iblue/mhi-xy-bus/(threads)

Thread 1 (2025-06-16):

Missing annexes in document - schematic + reference implementation

roelbouw, 2025-06-16:
Great work on the protocol analysis.

The "Project scope" section of your document lists a description/schematic of the circuitry used in appendix A, and an Arduino example implemenation in Annex B.

However, the document in this git does not include either Annex. Would you mind also publishing those?
