iblue/mhi-xy-bus/aircohack/Disconnector.asc

M1: nmos; BSP89
Q1: npn; BC547C
R1: res; 100k
R2: res; 10k
R3: res; 100k
V1: voltage; 17V
Named nets: 0
.tran 100m
