iblue/mhi-xy-bus/aircohack/Drive2r.asc

100k: res; 47k
C1: cap; 100µ
C2: cap; 20µ
C3: cap; 100n
C4: cap; 100n
C5: cap; 10n
C6: cap; 10n
C7: cap; 10µ
C8: cap; 10µ
C9: cap; 10µ
D1: diode
D2: diode
Q1: npn; BC547C
Q2: npn; BC547C
Q3: npn; BC547C
Q4: npn; BC547C
Q5: npn; BC547C
Q6: npn; BC547C
R4: res; 200
R5: res; 1k
R6: res; 180
R7: res; 47k
R8: res; 1k
R9: res; 10k
R10: res; 10k
R11: res; 10k
R12: res; 100k
R13: res; 10k
V1: voltage; 17; Rser=20
V2: voltage; 17; Rser=20
V3: voltage; PULSE(5 0 1.5s 0 0 60u 1247u 16)
V4: voltage; PULSE(5 0 1.5004 0 0 60u 1247u 16)
Named nets: 0, VH, VL, CLK, Vin, VHI, BUS
.tran 0 2 1 1m startup
Astabiler Multivibrator
Spannungsteiler lädt in C
Ladungspumpe
f=17kHz
U_H = 22.6 V
U_L = 12.1 V
Ladezeit < 1.2s
Bus-Simulator
Ausgangstreiber
