iblue/mhi-xy-bus/aircohack/Driver3.asc

C1: cap; 0.1µ; V=4 Irms=1.62 Rser=0.0464862 Lser=0 mfg="KEMET" pn="C0402C104K7PAC" type="X5R"
C2: cap; 0.1µ; V=4 Irms=1.62 Rser=0.0464862 Lser=0 mfg="KEMET" pn="C0402C104K7PAC" type="X5R"
M1: nmos
M2: nmos
M3: nmos
M4: nmos
M5: nmos
M6: nmos
M7: nmos
R1: res; 200
R2: res; 200
R3: res; 1000000
R4: res; 1000000
R5: res; 10k
V1: voltage; 17
V2: voltage; 5
V3: voltage; PULSE(30 0 1 0 0 1 2 1)
V4: voltage; PULSE(0 30 1 0 0 1 2 1)
Named nets: LD17ON, LD5ON, OUT22ON, 0, BUSOUT, LD5GND, LD17GND
.tran 5 startup
