iblue/mhi-xy-bus/aircohack/Driver5.asc

C2: cap; 1µ; V=4 Irms=1.62 Rser=0.0464862 Lser=0
M1: nmos
M2: nmos
M3: nmos
M4: nmos
M5: nmos
M7: nmos
R1: res; 1000000
R2: res; 10
V2: voltage; 5
V3: voltage; PULSE(5 0 0.95 10m 10m 1.1 2 1)
V4: voltage; PULSE(0 5 1.05 10m 10m 0.95 2 1)
Named nets: LD5ON, FWD, 0
.tran 0 5 0 1m startup
