iblue/mhi-xy-bus/aircohack/DriverA1.asc

C1: cap; 10µ
D1: schottky; BAT54
D2: schottky; BAT54
R1: res; 220
V1: voltage; PULSE(5 0 500m 0 0 52u 1248u); Rser=20
V2: voltage; 17V
Named nets: 0, OUT
.tran 0 1 0 100u startup
