iblue/mhi-xy-bus/aircohack/DriverA4.asc

C1: cap; 47µ
D1: schottky; BAT54
D2: schottky; BAT54
Q1: npn; BC847C
Q2: npn; BC847C
Q3: npn; BC847C
Q4: npn; BC847C
R1: res; 220
R2: res; 1k
R3: res; 1k
R4: res; 1k
R5: res; 2k
R6: res; 1k
V1: voltage; PULSE(0 5 500m 1u 1u 52u 1248u)
V2: voltage; 17V
V3: voltage; 5
V4: voltage; PULSE(0 5 500.16m 1u 1u 52u 1248u)
Named nets: OUT, 0
.tran 0 1 0 100u startup
7905 + uC
5V
0V
-12V
