iblue/mhi-xy-bus/aircohack/DriverA8.asc

C1: cap; 47µ
D1: schottky; BAT54
D2: schottky; BAT54
Q1: npn; BC847C
Q2: npn; BC847C
Q3: npn; BC847C
Q4: npn; BC847C
Q5: npn; BC847C
Q6: npn; BC847C
Q7: npn; BC847C
R2: res; 10k
R3: res; 1k
R4: res; 10k
R5: res; 2k
R6: res; 10k
R7: res; 10k
R8: res; 10k
R9: res; 1k
R10: res; 10k
R11: res; 10k
V1: voltage; PULSE(0 5 500m 1u 1u 52u 1248u); Rser=2000
V3: voltage; 5; Rser=80
V4: voltage; PULSE(0 5 500.16m 1u 1u 80u 1248u); Rser=2000
Named nets: OUT, 0, H, L, Vin
.tran 0 1 0 100u startup
7905 + uC
5V
0V
