iblue/mhi-xy-bus/aircohack/DriverB1.asc

M1: nmos
Q1: npn; BC847C
R1: res; 10k
R2: res; 1k
V1: voltage; PULSE(0 5 500m 1u 1u 52u 1248u); Rser=2000
V2: voltage; 17V; Rser=220
V3: voltage; 5; Rser=80
V4: voltage; PULSE(0 5 500.16m 1u 1u 52u 1248u); Rser=2000
V5: voltage; 22; Rser=10
V6: voltage; 12; Rser=10
Named nets: OUT, H, L, VIN, 0
.tran 0 1 0 100u startup
7905 + uC
0V
