iblue/mhi-xy-bus/aircohack/DriverB4.asc

C1: cap; 100n
C2: cap; 100n
Q1: npn; BC847C
Q2: pnp; BC857C
Q3: npn; BC847C
R1: res; 3900
R2: res; 10k
R3: res; 1k
R4: res; 100
U1: 7805
V1: voltage; PULSE(0 5 500m 1u 1u 52u 1248u); Rser=2000
V2: voltage; 17; Rser=220
V3: voltage; 5; Rser=80
V4: voltage; PULSE(5 0 500.16m 1n 1n 52u 1248u); Rser=2000
V5: voltage; 22; Rser=10
V6: voltage; 12; Rser=10
V7: voltage; 8; Rser=10
Named nets: OUT, H, L_inv, VIN, 0
.tran 0 1 0 100u startup
7905 + uC
0V
