iblue/mhi-xy-bus/aircohack/DriverC10.asc

C1: cap; 100µ
C2: cap; 100µ
C3: cap; 2.2n
C4: cap; 4.7n
C5: cap; 22µ
C7: cap; 100µ
C8: cap; 100µ
C9: cap; 2.2n
C?: cap; 4.7n
D1: diode
D2: diode
Q1: npn; BC847C
Q2: pnp; BC857C
Q3: npn; BC847C
Q4: npn; BC847C
Q5: npn; BC847C
Q6: npn; BC847C
Q7: npn; BC847C
Q8: pnp; BC807-40
Q9: npn; BC847C
R1: res; 10k
R2: res; 9k
R3: res; 220
R4: res; 56
R5: res; 1k5
R6: res; 10k
R7: res; 1k5
R8: res; 1k5
R9: res; 10k
R10: res; 10k
R11: res; 220
R12: res; 22
R13: res; 1k
R14: res; 10k
R16: res; 1k
R17: res; 100k
R18: res; 100k
R19: res; 1k
R20: res; 100k
U1: opamp2; LM358
U3: opamp2; LM358
V2: voltage; 17; Rser=20
V3: voltage; PULSE(5 0 1.5s 0 0 60u 1247u 16)
V4: voltage; PULSE(5 0 1.5004 0 0 60u 1247u 16)
V5: voltage; PULSE(0 5 0 1us 1us 249us 500us)
V6: voltage; 5
ZD1: zener; BZX84C12L
ZD3: zener; BZX84C24VL
Named nets: 0, CLK, VHI, VH, VL, BUS, Vin
.tran 2 startup uic
Ladungspumpe
TODO: 
- Bus = Eingangsspannung
- Eingangspannung wird in C gepuffert und ist abschaltbar
- CLK kommt von uC
- uC in separate Sektion schieben
- Levels der Ausgangsspannung pruefen (22V / 12V)
*//////////////////////////////////////////////////////////////////////
* (C) National Semiconductor, Inc.
* Models developed and under copyright by:
* National Semiconductor, Inc.  
 
*/////////////////////////////////////////////////////////////////////
* Legal Notice: This material is intended for free software support.
* The file may be copied, and distributed; however, reselling the 
*  material is illegal
 
*////////////////////////////////////////////////////////////////////
* For ordering or technical information on these models, contact:
* National Semiconductor's Customer Response Center
*                 7:00 A.M.--7:00 P.M.  U.S. Central Time
*                                (800) 272-9959
* For Applications support, contact the Internet address:
*  amps-apps@galaxy.nsc.com
 
*//////////////////////////////////////////////////////////
*LM358 DUAL OPERATIONAL AMPLIFIER MACRO-MODEL
*//////////////////////////////////////////////////////////
*
* connections:      non-inverting input
*                   |   inverting input
*                   |   |   positive power supply
*                   |   |   |   negative power supply
*                   |   |   |   |   output
*                   |   |   |   |   |
*                   |   |   |   |   |
.SUBCKT LM358       1   2  99  50  28
*
*Features:
*Eliminates need for dual supplies
*Large DC voltage gain =             100dB
*High bandwidth =                     1MHz
*Low input offset voltage =            2mV
*Wide supply range =       +-1.5V to +-16V
*
*NOTE: Model is for single device only and simulated
*      supply current is 1/2 of total device current.
*      Output crossover distortion with dual supplies
*      is not modeled.
*
****************INPUT STAGE**************
*
IOS 2 1 5N
*^Input offset current
R1 1 3 500K
R2 3 2 500K
I1 99 4 100U
R3 5 50 517
R4 6 50 517
Q1 5 2 4 QX
Q2 6 7 4 QX
*Fp2=1.2 MHz
C4 5 6 128.27P
*
***********COMMON MODE EFFECT***********
*
I2 99 50 75U
*^Quiescent supply current
EOS 7 1 POLY(1) 16 49 2E-3 1
*Input offset voltage.^
R8 99 49 60K
R9 49 50 60K
*
*********OUTPUT VOLTAGE LIMITING********
V2 99 8 1.63
D1 9 8 DX
D2 10 9 DX
V3 10 50 .635
*
**************SECOND STAGE**************
*
EH 99 98 99 49 1
G1 98 9 POLY(1) 5 6 0 9.8772E-4 0 .3459
*Fp1=7.86 Hz
R5 98 9 101.2433MEG
C3 98 9 200P
*
***************POLE STAGE***************
*
*Fp=2 MHz
G3 98 15 9 49 1E-6
R12 98 15 1MEG
C5 98 15 7.9577E-14
*
*********COMMON-MODE ZERO STAGE*********
*
*Fpcm=10 KHz
G4 98 16 3 49 5.6234E-8               
L2 98 17 15.9M
R13 17 16 1K
*
**************OUTPUT STAGE**************
*
F6 50 99 POLY(1) V6 300U 1
E1 99 23 99 15 1
R16 24 23 17.5
D5 26 24 DX
V6 26 22 .63V
R17 23 25 17.5
D6 25 27 DX
V7 22 27 .63V
V5 22 21 0.27V
D4 21 15 DX
V4 20 22 0.27V
D3 15 20 DX
L3 22 28 500P
RL3 22 28 100K
*
***************MODELS USED**************
*
.MODEL DX D(IS=1E-15)
.MODEL QX PNP(BF=1.111E3)
*
.ENDS
*$
U_H = 23.9 V
Impedanzwandler vor Ausgangstreiber
U_L = 12 V
Impedanzwandler vor Ausgangstreiber
Ausgangstreiber
Sendebereit nach 250ms ab Aktivierung von CLK
DeltaT = 40.5 K bei 670 mA
Power Switch
