iblue/mhi-xy-bus/aircohack/Filter1.asc

C1: cap; 15n; V=25 Irms=728m Rser=0.14361 Lser=0
Q1: npn
R1: res; 10k; tol=5
R2: res; 22k
R3: res; 500
R4: res; 10k
R5: res; 40k
V1: voltage; PWL file=pwl-out.txt; Rser=10
V2: voltage; 5
Named nets: 0, In
.tran 10m
