iblue/mhi-xy-bus/aircohack/Filter2.asc

C1: cap; 15n; V=25 Irms=728m Rser=0.14361 Lser=0
C2: cap; 200n
Q1: npn
Q2: npn
Q3: npn
Q4: npn
R1: res; 10k; tol=5
R2: res; 22k
R3: res; 500
R4: res; 10k
R5: res; 40k
R6: res; 220
R7: res; 15k
R8: res; 100
R9: res; 100
R10: res; 10k
R11: res; 1k
R12: res; 10k
R13: res; 1k
V1: voltage; PWL file=pwl-out.txt
V2: voltage; 5
Named nets: 0, In
.tran 10m
