iblue/mhi-xy-bus/(list of files, drawings)

Other design files:
aircohack/platine/mhixy.dsn
