iblue/mhi-xy-bus/aircohack/platine/mhixy.kicad_pcb

## KiCad design aircohack/platine/mhixy.kicad_pcb (2026-01-11)

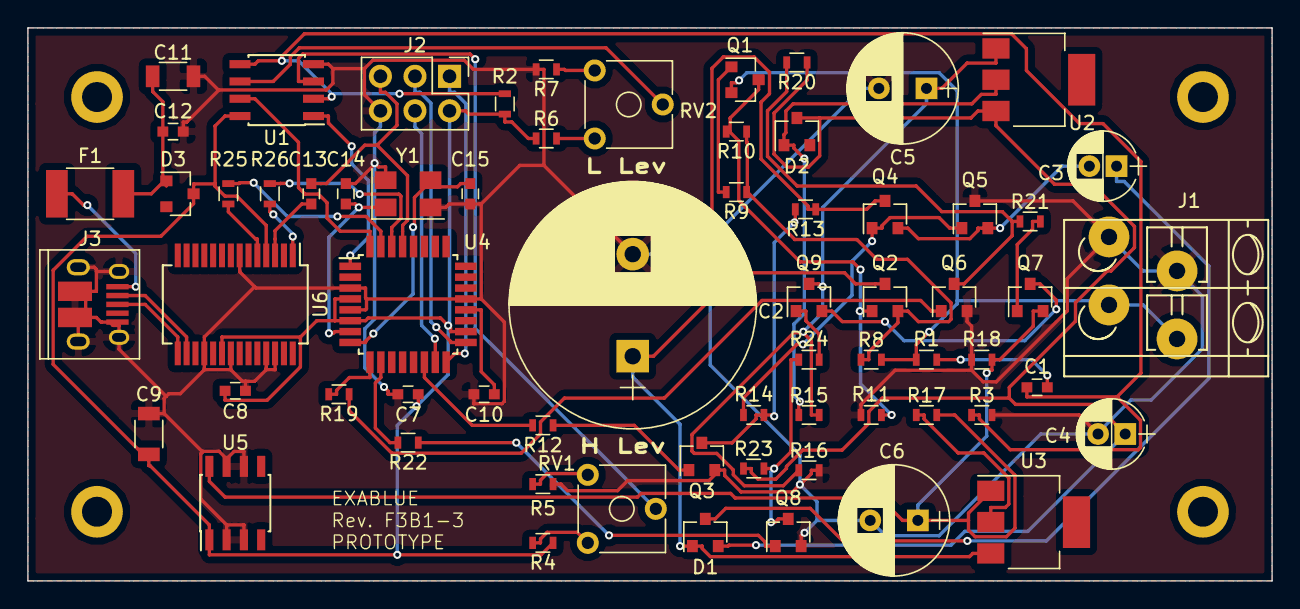
[picture p2: board mhixy.kicad_pcb from above]

Board: 2 copper layers, 91.4 x 40.6 mm, 70 parts (0 on the bottom side), 53 nets.

Parts:
C1: 47n; C_0603
C2: 4700u; CP_Radial_D18.0mm_P7.50mm
C3, C4: 22u; CP_Radial_D5.0mm_P2.00mm
C5, C6: 100u; CP_Radial_D8.0mm_P3.50mm
C7, C8: 1u; C_0603
C9, C11: 4u7; C_1206
C10, C12, C13: 100n; C_0603
C14, C15: 12p; C_0603
D1: BAT54S; SOT-23
D2, D3: BAT54; D_SOT-23_ANK
F1: Polyfuse; R_1812
H1, H2, H3, H4: MountingHole_2.2mm_M2_DIN965_Pad
J1: MHI Bus; TerminalBlock_WAGO-804_RM5mm_2pol
J2: ISP; Pin_Header_Straight_2x03_Pitch2.54mm
J3: USB_OTG; USB_Micro-B_10103594-0001LF
Q1: BC857A; SOT-23
Q2, Q5, Q7, Q9: BC807-40; SOT-23
Q3, Q6, Q8: BC847C; SOT-23
Q4: BC817-40; SOT-23
R1: 47k; R_0603
R2, R3, R11: 220k; R_0603
R4, R5, R6, R7: 25k; R_0603
R8: 1; R_0603
R9: 2k2; R_0603
R10: 22k; R_0603
R12, R13, R19, R21, R22, R24: 10k; R_0603
R14, R25, R26: 1k; R_0603
R15, R17: 220; R_0603
R16: 3k9; R_0603
R18: 1k8; R_0603
R20, R23: 100k; R_0603
RV1, RV2: 50k; Potentiometer_Trimmer_ACP_CA6v_Horizontal
U1: LM358; SOIC-8_3.9x4.9mm_Pitch1.27mm
U2, U3: LM317M; SOT-223
U4: ATMEGA328-AU; TQFP-32_7x7mm_Pitch0.8mm
U5: 78L05; SOIC-8_3.9x4.9mm_Pitch1.27mm
U6: FT232RL; SSOP-28_5.3x10.2mm_Pitch0.65mm
Y1: 16MHz; Crystal_SMD_5032-4pin_5.0x3.2mm

Connections:
+5V: C7.1, C8.1, C9.1, D3.1, J2.2, R2.1, R4.1, R6.1, U1.8, U4.4, U4.6, U4.18, U5.1, U6.4, U6.20
/ChargePump/17V: C2.1, D1.1, Q2.3, Q4.3, R13.1, U3.3
/ChargePump/32V: C4.1, D1.2, D2.1, R20.1, R23.1, U2.3
/ChargePump/CLK: R12.2, U4.14
/Controller/RXHI: U1.1, U4.1
/Controller/RXLO: U1.7, U4.32
/Generators/12V: C6.1, Q7.2, R17.2, R18.1, U3.1, U5.8
/Generators/22V: C5.1, Q9.3, R15.2, R16.1, U2.1
/OutputDriver/BusOut: Q7.3, Q9.2
/OutputDriver/TTLInHigh: R22.2, U4.10
/OutputDriver/TTLInLow: R19.2, U4.9
Bus: J1.1, Q1.2, R1.2, R8.2
Filtered: C1.1, R2.2, R3.1, U1.2, U1.5
GND: C2.2, C4.2, C5.2, C6.2, C7.2, C8.2, C9.2, C10.2, C11.2, C12.2, C14.1, C15.1, J1.2, J2.6, J3.5, J3.6, Q3.2, Q5.3, Q6.2, Q8.2, R3.2, R5.2, R7.2, R11.2, R16.2, R18.2, U1.4, U4.3, U4.5, U4.21, U5.2, U5.3, U5.6, U5.7, U6.7, U6.18, U6.21, U6.25, U6.26, Y1.2, Y1.4
MISO: J2.1, U4.16
MOSI: J2.4, U4.15
unnamed: C1.2, R1.1
unnamed: C3.1, D1.3
unnamed: C3.2, Q4.2, Q5.2
unnamed: C10.1, U4.20
unnamed: C11.1, C12.1, D3.2, F1.1
unnamed: C13.2, U6.3
unnamed: C14.2, U4.7, Y1.1
unnamed: C15.2, U4.8, Y1.3
unnamed: D2.2, R15.1, U2.2
unnamed: F1.2, J3.1
unnamed: J3.2, U6.16
unnamed: J3.3, U6.15
unnamed: Q1.1, R9.2
unnamed: Q1.3, Q2.1, R10.2, R11.1
unnamed: Q2.2, R8.1, R9.1, R10.1
unnamed: Q3.1, R12.1
unnamed: Q3.3, R13.2, R14.2
unnamed: Q4.1, Q5.1, R14.1
unnamed: Q6.1, R19.1
unnamed: Q6.3, R20.2, R21.1
unnamed: Q7.1, R21.2
unnamed: Q8.1, R22.1
unnamed: Q8.3, R23.2, R24.1
unnamed: Q9.1, R24.2
unnamed: R4.2, RV1.1
unnamed: R5.1, RV1.3
unnamed: R6.2, RV2.1
unnamed: R7.1, RV2.3
unnamed: R17.1, U3.2
unnamed: R25.2, U4.31
unnamed: R26.2, U4.30
unnamed: RV1.2, U1.3
unnamed: RV2.2, U1.6
RESET: C13.1, J2.5, U4.29
RX: R26.1, U6.1
SCK: J2.3, U4.17
TX: R25.1, U6.5
